NarodniySputnik/Gladiolus-1/README.md

# Проект Gladiolus-1 (Народный Спутник)
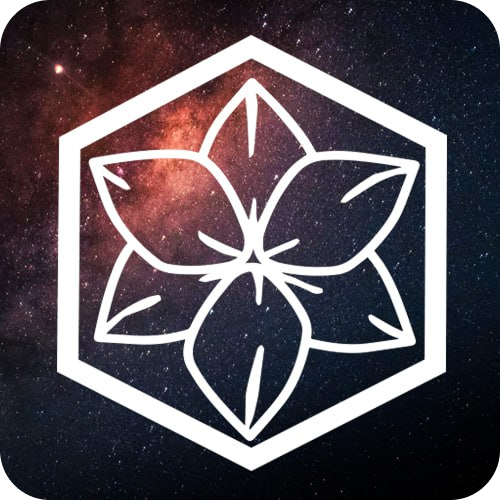
[picture p1: doc/img/logo.png]


Мы - команда радиолюбителей-энтузиастов под руководством Дмитрия R4UAB Пашкова!
В данный момент мы работаем над проектом "Народный спутник"! 
Наша цель - это создание функционального малого космического аппарата (CubeSat) для популяризации радиолюбительства, как интересного и увлекательного занятия для людей всех возрастов. Проект создаётся полностью на добровольных началах и заинтересованности наших участников. 

Наши задачи: 

- Реализовать полный цикл создания малого космического аппарата CubeSat - от проектирования и сборки до запуска и работы на орбите. 
- Предоставить открытые данные и существующие наработки по проекту для всех желающих, вдохновить всех любителей космической тематики и радиолюбителей на разработку и участие в новых интересных технологических проектах. 
- Объединить единомышленников для практической работы в области космических технологий и радиосвязи.

С огромнейшим удовольствием примем в нашу команду всех кто может и хочет приложить руку к созданию реального космического аппарата!

We are a team of amateur radio enthusiasts led by Dmitry "R4UAB" Pashkov!
We are currently working on the "People's Satellite" project! Our goal is to create a functional small spacecraft (CubeSat) to popularize amateur radio as an interesting and engaging activity for people of all ages. The project is being developed entirely on a voluntary basis and based on the passion of our participants.

Our goals:

- Implement the full development cycle of the CubeSat small spacecraft-from design and assembly to launch and operation in orbit.
- Provide open data and existing project developments to everyone, inspiring all space enthusiasts and radio amateurs to develop and participate in new exciting technological projects.
- Bring together like-minded individuals for practical work in the field of space technology and radio communications.

We are delighted to welcome anyone who can and wants to contribute to the creation of a real spacecraft to our team!

## Структура директорий
- doc - Документы
	- ds - Технические спецификации
	- img - Изображения
	- info - Информация
	- ref - Референсы и примеры
- firmware - Прошивки
- hardware - Печатные платы и схемы
	- library - Библиотеки KiCad
- software - Программы

## Назначение модуля
Gladiolus-1 - автономный модуль для приема и передачи изображений в формате SSTV (Slow Scan TeleVision) на малом космическом аппарате (МКА) формата CubeSat

1.2. Основание для разработки
Решение технического комитета проекта «Gladiolus-1» 

1.3. Назначение
Создание функциональной полезной нагрузки для:

Приёма команд с Земли <br>
Съёмки поверхности Земли <br>
Генерации и передачи изображений в формате SSTV <br>
Приёма и ретрансляции цифровых пакетных данных <br>
Проведения образовательных и научных экспериментов

1.4. Краткое описание системы<br>
Полезная нагрузка представляет собой модульную систему, построенную на основе единой шинной архитектуры. Система включает в себя два вычислительных блока различной архитектуры, обеспечивающих резервирование и распределение функций, два идентичных модемных блока с возможностью взаимозамены, центральный блок управления питанием и данными, а также антенную систему.

2. ОБЩИЕ ТРЕБОВАНИЯ

2.1. Эксплуатационные характеристики

<div align="left">
<table>
<tr><td>Формат:</td><td>CubeSat 1U (габариты 100×100×113,5 мм)</td></tr>
<tr><td>Орбита:</td><td>Низкая околоземная орбита (высота 500–600 км), солнечно-синхронная</td></tr>
<tr><td>Энергопотребление среднее:</td><td>не более 2Вт</td></tr>
<tr><td>Энергопотребление пиковое:</td><td>Не более 5Вт</td></tr>
<tr><td>Масса:</td><td>Не более 1.33кг</td></tr>
<tr><td>Габариты:</td><td>Соответствуют стандарту CubeSat 1U</td></tr>
</table></div>
Режимы работы должны обеспечивать положительный энергобаланс

2.2. Условия эксплуатации

<div align="left">
<table>
<tr><td>Температурный диапазон:</td><td>–40°C до +80°</td></tr>
<tr><td>Вибронагрузки:</td><td>Соответствуют стандартам запуска CubeSat</td></tr>
<tr><td>Ударные нагрузки:</td><td>До 100g</td></tr>
<tr><td>Вакуум:</td><td>До 10⁻⁶ Торр</td></tr>
<tr><td>Радиационная стойкость:</td><td>Критическая накопленная доза облучения 20 крад (Si)</td></tr>
</table></div>

2.3. Интерфейсы с платформой спутника
<div align="left"><table>
<tr><td>Питание:</td><td>Напряжение шины питания 3.2-8.4 В, ток до 1 А</td></tr>
<tr><td>Механический интерфейс:</td><td>Стандартные крепления CubeSat</td></tr>
<tr><td>Тепловой интерфейс:</td><td>Кондуктивный отвод тепла на платформу</td></tr>
<tr><td>Другие интерфейсы:</td><td>Не предусмотрены</td></tr>

</table></div>

3. ФУНКЦИОНАЛЬНОЕ ДЕЛЕНИЕ И ТРЕБОВАНИЯ К БЛОКАМ

3.1. БЦВМ 1 (Бортовая Цифровая Вычислительная Машина 1)

3.1.1. Аппаратная платформа:

<div align="left"><table>
<tr><td>Основной процессор:</td><td>Raspberry Pi Zero v1.3</td></tr>
<tr><td>Память:</td><td>Оперативная 512 МБ, флеш-память microSD</td></tr>
<tr><td>Тактовая частота:</td><td>Программно регулируемая от минимальной до номинальной</td></tr>
<tr><td>Отключаемые интерфейсы:</td><td>USB, HDMI, ненужные периферийные модули</td></tr>
</table></div>

3.1.2. Функции:

<div align="left">
<table>
<tr><td>Управление файловой системой бортового накопителя</td></tr>
<tr><td>Общее управление системой и координация работы блоков</td></tr>
<tr><td>Обработка команд и телеметрии</td></tr>
<tr><td>Маршрутизация данных между подсистемами</td></tr>
<tr><td>Резервная функция программной генерации сигнала SSTV</td></tr>
<tr><td>Ведение журнала работы системы</td></tr>
</table></div>

3.1.3. Интерфейсы:

<div align="left">
<table>
<tr><td>1× 40-контактный разъем для подключения к материнской плате</td></tr>
<tr><td>Поддержка шин RS-485 и I2C</td></tr>
</table></div>

3.2. БЦВМ 2 (Бортовая Цифровая Вычислительная Машина 2)

3.2.1. Аппаратная платформа: <br>
Основной микроконтроллер: STM32 серии (конкретная модель по результатам анализа) <br>
Периферия: <br>
Встроенный RTC с независимым питанием <br>
Интерфейс DCMI для подключения камеры <br>
2× UART для шин RS-485 <br>
Интерфейсы I2C, SPI для дополнительной периферии <br>
Внешняя SPI-Flash или SD-карта для хранения данных <br>
Режимы работы: Поддержка энергоэффективных режимов <br>

3.2.2. Функции:
Управление камерой: инициализация, захват кадра, настройка параметров <br>
Обработка изображений и подготовка данных для передачи в формате SSTV <br>
Управление SSTV-передатчиком <br>
Синхронизация операций по времени с помощью RTC <br>
Дублирующее управление бортовым накопителем <br>
Резервирование критических функций БЦВМ 1 <br>

3.2.3. Взаимодействие между БЦВМ:
Обмен данными через единые шины RS-485 <br>
Взаимный мониторинг состояния и работоспособности <br>
Автоматическое перераспределение функций при отказах <br>
Синхронизация времени и планирование задач

3.3. Модемный блок (в количестве 2 шт.)
3.3.1. Аппаратная основа:

<div align="left"><table>
<tr><td>Радиомодули:</td><td>На каждый блок: Ra-02 (на основе SX1278)</td></tr>
<tr><td>Усилители:</td><td>МШУ на приём, усилитель AB-IOT-433 передачу</td></tr>
<tr><td>Фильтры:</td><td>ПАВ-фильтры на приём и передачу</td></tr>
<tr><td>Согласующие цепи:</td><td>Wideband matching networks</td></tr>
<tr><td>Микроконтроллер:</td><td>MSP430FR5994IPNR</td></tr>
</table></div>

3.3.2. Функциональное назначение:

<div align="left">
<table>
<tr><td>Радиомодуль 1:</td><td>SSTV передатчик (ЧМ модуляция, 438МГц)</td></tr>
<tr><td>Радиомодуль 2:</td><td>Цифровая радиолиния (435Мгц)</td></tr>
<tr><td>Резервирование:</td><td>Возможность переконфигурации модулей</td></tr>
</table></div>

3.3.3. Электрические параметры:

<div align="left">
<table>
<tr><td>Мощность передатчика:</td><td>До 2Вт (регулируемая)</td></tr>
<tr><td>Чувствительность приёмника:</td><td>Не хуже -130dBm</td></tr>
<tr><td>Стабильность частоты:</td><td>±1 ppm</td></tr>
<tr><td>Потребляемый ток:</td><td>Передача ≤ 500 мА, прием ≤ 50 мА</td></tr>
</table></div>

3.3.4. Дополнительные функции:
Контроль температуры через I2C<br>
Мониторинг параметров усилителей<br>
Защита от КЗ и перегрева<br>
Автоматическая калибровка

3.4. Материнский блок (Блок управления питанием и данными)

3.4.1. Система питания:

<div align="left"><table>
<tr><td>Вход:</td><td>3.2-8.4В от платформы спутника</td></tr>
<tr><td>Выход:</td><td>Стабилизированное +5В через интеллектуальные ключи</td></tr>
<tr><td>КПД:</td><td>Не менее 90% при номинальной нагрузке</td></tr>
<tr><td>Защите:</td><td>Ограничение тока, защита от КЗ, от перенапряжения</td></tr>
</table></div>

3.4.2. Управление и мониторинг:

<div align="left">
<table>
<tr><td>Централизованный сбор телеметрии через I2C</td></tr>
<tr><td>Управление питанием каждого блока</td></tr>
<tr><td>Аппаратный watchdog (MAX6301)</td></tr>
<tr><td>Счетчик перезагрузок в энергонезависимой памяти</td></tr>
</table></div>

3.4.3. Интерфейсы:

<div align="left">
<table>
<tr><td>4× 40-контактных разъема для функциональных блоков</td></tr>
<tr><td>2× шины RS-485 с протоколом AX.25</td></tr>
<tr><td>Шина I2C с мультиплексором для изоляции подключенных блоков</td></tr>
</table></div>

3.4.4. Система I2C мультиплексирования:
Архитектура: Мультиплексор I2C с 8 и более каналами

Назначение каналов:

<div align="left">
<table>
<tr><td>Канал 0:</td><td>Внутренние датчики материнского блока</td></tr>
<tr><td>Канал 1:</td><td>БЦВМ</td></tr>
<tr><td>Канал 2:</td><td>БЦВМ</td></tr>
<tr><td>Канал 3:</td><td>Модемный блок 1</td></tr>
<tr><td>Канал 4:</td><td>Модемный блок 2</td></tr>
<tr><td>Канал 5:</td><td>Резерв</td></tr>
<tr><td>Канал 6:</td><td>Резерв</td></tr>
<tr><td>Канал 7:</td><td>Резерв</td></tr>
</table></div>

<div align="left">
<table>
<tr><td>Управление:</td><td>Программное переключение каналов мультиплексора</td></tr>
<tr><td>Восстановление:</td><td>Автоматический сброс зависших устройств</td></tr>
</table></div>

3.4.5. Мониторинг питания: <br>
Детектирование аварий: Мониторинг напряжения на линии PWR_FAULT <br>
Реакция на аварии: Автоматическое отключение питания блока при аварии <br>
Логирование: Запись событий аварий питания

3.5. Антенный блок
<div align="left"><table>
<tr><td>Диапазоны:</td><td>435 и 438МГц</td></tr>
<tr><td>Поляризация:</td><td>Линейная</td></tr>
<tr><td>КСВ:</td><td>Не более 1.5 в рабочем диапазоне</td></tr>
<tr><td>Конструктив:</td><td>Складываемая конструкция, совместимая с 1U CubeSat</td></tr>
<tr><td>Коэффициент усиления:</td><td>Не менее 0 dBi для каждого диапазона</td></tr>
<td>Диаграмма направленности:</td><td>Широконаправленная для обеспечения связи при различных ориентациях спутника</td></tr>
</table></div>

3.6. Требования к унификации блоков

3.6.1. Стандартизация разъемов:<br>
Единый 40-контактный разъем для всех блоков <br>
Фиксированная распиновка (см. Таблицу 1) <br>
Механическая фиксация от самопроизвольного отключения

Таблица 1. Распиновка 40-контактного разъема
<div align="left">
<table>
<tr>
<th>Контакты</th><th>Назначение</th><th>Описание</th></tr>
<tr><td>1-4</td><td>+5V</td><td>Питание +5В</td></tr>
<tr><th>5-8</th><th>GND</th><th>Земля</th></tr>
<tr><td>I2C</td><td>SCL</td><td>SCL</td></tr>
<tr><td>I2C</td><td>SDA</td><td>SDA</td></tr>
<tr><td>I2C_PWR</td><td></td><td>Плюс питания</td></tr>
<tr><td>I2C_GND</td><td></td><td>Земля</td></tr>
<tr><td>A1, B2</td><td>RS-485</td><td>2 контакта</td></tr>
<tr><td>PWR_EN</td><td>управление</td><td>включение питания</td></tr>
<tr><td>RESET</td><td>Сброс</td><td>включение питания</td></tr>
<tr><td>PWR_FAULT</td><td>Мониторинг</td><td>1 контакт</td></tr>
<tr><td>PWR_FAULT</td><td>Резерв</td><td>21 контакт</td></tr>
</table></div>

3.6.2. Организация шин:<br>
Параллельное подключение всех блоков к общим шинам<br>
Индивидуальное управление питанием<br>
Единые протоколы обмена

4. ТРЕБОВАНИЯ К ИНТЕРФЕЙСАМ И ПРОТОКОЛАМ

4.1. Физический уровень
RS-485: Двухпроводная дифференциальная шина<br>
Скорость: 1200-2000000 бод<br>
I2C: Стандартный протокол с тактовой частотой до 400 кГц (Fast Mode)

<div align="left"><table>
<tr><td>RS-485</td><td>Двухпроводная дифференциальная шина</td></tr>
<tr><td>Скорость:</td><td>1200-2000000 бод</td></tr>
<tr><td>I2C</td><td>Стандартный протокол с тактовой частотой до 400 кГц</td></tr>
</table></div>

4.2. Протокол обмена

<div align="left"><table>
<tr><td>Базовый протокол</td><td>AX.25</td></tr>
<tr><td>Формат пакетов</td><td>HDLC-like frame structure</td></tr>
<tr><td>Контроль ошибок</td><td>CRC-16</td></tr>
<tr><td>Адресация</td><td>расширенная схема адресации подсистем</td></tr>
</table></div>

4.3. Логика работы <br>
Широковещательная и адресная передача <br>
Подтверждение приема критических команд <br>
Повторная передача при ошибках <br>
Приоритезация пакетов

4.4. Протокол обмена по I2C

<div align="left"><table><tr>
<td>Адресация устройств</td><td>7-битная схема адресации</td></tr>
<tr><td>Скорость обмена</td><td>до 400 кбит/сек</td></tr>
<tr><td>Формат сообщений</td><td>Управляющие команды <br> Данные телеметрии <br> Статусные сообщения</td></tr>
<tr><td>Арбитраж</td><td>Автоматическое разрешение коллизий</td></tr>
<tr><td>Таймауты</td><td>Защита от зависания шины</td></tr>
</table></div>

5. МЕХАНИЧЕСКИЕ И КОНСТРУКТИВНЫЕ ТРЕБОВАНИЯ

5.1. Компоновка

<div align="left"><table>
<tr><td>Формат</td><td>1U CubeSat (100x100x113, 5мм)</td></tr>
<tr><td>Количество плат:</td><td>3-4 печатных платы в стэке</td></tr>
<tr><td>Высота компонентов:</td><td>С учётом зазора между платами</td></tr>
</table></div>

5.2. Материалы

<div align="left"><table>
<tr><td>Основа плат:</td><td>FR-4 c Tg ≥ 170°C</td></tr>
<tr><td>Покрытие:</td><td>Конформное покрытие для защиты от влаги и загрязнений</td></tr>
<tr><td>Защитные покрытия:</td><td>Использование металлов без защитного покрытия не допускается. Все металлические поверхности должны иметь защитное покрытие для функционирования в космических условиях</td></tr>
<tr><td>Монтажные компоненты:</td><td>Использование оловянно-свинцовых припоев (Sn63Pb37 или аналог). Бессвинцовые припои не допускаются.</td></tr>
</table></div>

5.3. Тепловой режим <br>
Пассивное охлаждение через корпус<br>
Распределение тепловыделяющих компонентов<br>
Тепловой контакт с платформой спутника

6. ТРЕБОВАНИЯ К НАДЁЖНОСТИ

6.1. Показатели надежности

<div align="left">
<table>
<tr><td>Средняя наработка на отказ:</td>
<td>≥ 10 000 часов</td></tr>
<tr><td>Вероятность безотказной работы:</td>
<td>≥ ≥ 0.95 за 1 год</td></tr>
<tr><td>Коэффициент готовности:</td>
<td>≥ 0.98</td></tr>
</table></div>

6.2. Радиационная стойкость

6.2.1. Критерии стойкости: <br>
Сохранение работоспособности до 20 крад (Si)<br>
Постепенная деградация параметров после 20 крад<br>
Сохранение базовой функциональности до 25 крад

6.2.2. Методы обеспечения: <br>
Выбор компонентов с подтвержденной стойкостью<br>
Локальные экраны для чувствительных элементов<br>
Схемная избыточность и резервирование<br>
RAD-HARD компоненты для критических узлов

6.2.3. Испытания: <br>
Радиационные испытания на ускорителях<br>
Контроль параметров при дозах 10, 15, 20, 25 крад<br>
Тестирование на SEE и SEL<br>
Термоциклирование после облучения

6.2.4. Расчетные параметры: <br>
Запас 20% относительно расчетной дозы<br>
Учет всех видов ионизирующего излучения<br>
Моделирование радиационной обстановки

7. ТРЕБОВАНИЯ К ОТЛАДОЧНОМУ ОБОРУДОВАНИЮ

7.1. Плата-удлинитель для внешней отладки

7.1.1. Конструкция: <br>
Печатная плата с посадочным местом для функционального блока<br>
Штатный 40-контактный разъем со стороны спутника<br>
Механическое крепление блока винтами<br>
Тестовые точки и защитные элементы

7.1.2. Параметры: <br>
Сопротивление проводников: ≤ 0.1 Ом
Рабочая температура: -40°C до +80°C
Стойкость к вибрациям согласно требованиям

<div align="left"><table>
<tr><td>Сопротивление проводников:</td><td> ≤ 0.1 Ом</td></tr>
<tr><td>Рабочая температура:</td><td>-40°C до +80°C</td></tr>
<tr><td>Стойкость к вибрациям:</td><td>Cогласно требованиям</td></tr>
</table></div>

7.2. Плата-эмулятор материнской платы <br>
7.2.1. Функционал:
Эмуляция штатной материнской платы<br>
Управление питанием подключенного блока<br>
Мониторинг токопотребления<br>
Организация шин RS-485 и I2C

7.2.2. Интерфейсы: <br>
1× 40-контактный разъем для блока<br>
USB Type-C для питания и связи<br>
JTAG для низкоуровневой отладки<br>

7.2.3. Программное обеспечение: <br>
Графическая утилита для управления<br>
Эмуляция штатных режимов работы<br>
Логирование и анализ данных<br>
Библиотека тестовых сценариев<br>
Мониторинг шины I2C в реальном времени

7.2.4. Технические характеристики:

<div align="left"><table>
<tr><td>Входное напряжение</td><td>12 В DC или USB-C</td></tr>
<tr><td>Выходной ток</td><td>До 2А</td></tr>
<tr><td>Поддержка скоростей RS-485:</td><td>1200 бод - 2 Мбод</td></tr>
<tr><td>Поддержка I2C:</td><td>Standard Mode (100 кГц), Fast Mode (400 кГц)</td></tr>
<tr><td>Рабочая температура:</td><td>0°C до +50°C</td></tr>
</table></div>

7.3. Совместимость <br>
Полная электрическая и программная совместимость<br>
Использование в термовакуумной камере<br>
Соответствие требованиям наземных испытаний

8. ЭТАПЫ РАЗРАБОТКИ И ИСПЫТАНИЙ

8.1. Основные этапы <br>
Эскизное проектирование<br>
Разработка конструкторской документации<br>
Изготовление опытных образцов<br>
Проведение испытаний<br>
Изготовление летного образца<br>
Сопровождение запуска и эксплуатации

8.2. Виды испытаний <br>
Вибродинамические<br>
Термовакуумные<br>
Радиационные<br>
Электромагнитная совместимость<br>
Функциональные и комплексные

8.3. Требования к вибродинамическим испытаниям
8.3.1. Условия проведения испытаний: <br>
Температура: +20°C ±5°C <br>
Относительная влажность: 40-60% <br>
Крепление образца: Штатные крепежные элементы, момент затяжки согласно конструкторской документации <br>

8.3.2. Режимы вибрационных испытаний:

<div align="left">
<table>
<tr><th>Синусоидальная вибрация</th></tr>
<tr><td>Диапазон частот:</td><td>5-100Гц</td></tr>
<tr><td>Амплитуда:</td><td>20g</td></tr>
<tr><td>Скорость развёртки:</td><td>2 октавы/мин</td></tr>
<tr><td>Направления:</td><td>X, Y, Z оси</td></tr>
<tr><td>Количество циклов:</td><td>3 цикла на каждое направление</td></tr>
<tr><th>Случайная вибрация</th></tr>
<tr><td>Диапазон частот:</td><td>20-2000Гц</td></tr>
<tr><td>Спектральная плотность 20-100Гц</td><td>+3 дБ/окт</td></tr>
<tr><td>Спектральная плотность 100-700Гц</td><td>0.04 g²/Гц</td></tr>
<tr><td>Спектральная плотность 700-2000Гц</td><td>-3 дБ/окт</td></tr>
<tr><td>Общее СКУ ускорение</td><td>7.7 g (среднеквадратичное)</td></tr>
<tr><td>Длительность:</td><td>2 минуты на каждое направление</td></tr>
<tr><td>Направления:</td><td>X, Y, Z оси</td></tr>
</table></div>

8.3.3. Контроль во время испытаний: <br>
Непрерывный мониторинг электрических параметров<br>
Регистрация резонансных частот<br>
Визуальный контроль после каждого этапа испытаний<

8.3.4. Критерии успешного прохождения: <br>
Отсутствие механических повреждений<br>
Сохранение функциональности системы<br>
Отсутствие необратимых изменений параметров<br>
Соответствие резонансных частот требованиям конструкции

8.4. Требования к термовакуумным испытаниям

8.4.1. Условия проведения испытаний:

<div align="left">
<table>
<tr><td>Вакуум:</td><td>≤ 10⁻⁵ Торр</td></tr>
<tr><td>Температурный диапазон:</td><td>-40°C до +80°C</td></tr>
<tr><td>Скорость изменения температуры:</td><td>не более 5°C/мин</td></tr>
<tr><td>Температурные датчики:</td><td>не менее 6 точек контроля</td></tr>
</table></div>

8.4.2. Профиль температурных циклов:

<div align="left">
<table>
<tr><th>Квалификационные испытания</th></tr>
<tr><td>Количество циклов:</td><td>8 циклов</td></tr>
<tr><td>Выдержка на экстремумах:</td><td>4 часа</td></tr>
<tr><td>Температурный диапазон:</td><td>-45°C до +85°C</td></tr>
<tr><th>Приёмо-сдаточные испытания</th></tr>
<tr><td>Количество циклов:</td><td>4 цикла</td></tr>
<tr><td>Выдержка на экстремумах:</td><td>2 часа</td></tr>
<tr><td>Температурный диапазон:</td><td>-40°C до +80°C</td></tr>
</table></div>

8.4.3. Контроль параметров: <br>
Электрические параметры: <br>
Потребляемый ток в различных режимах<br>
Стабильность напряжений питания<br>
Работоспособность интерфейсов связи<br>
Функциональные проверки:<br>
Проверка работы камеры на всех температурах<br>
Тестирование радиоканалов<br>
Проверка систем обработки данных

8.4.4. Тепловой баланс:

<div align="left"><table>
<tr><td>Мощность нагревателей:</td><td>регулируемая, с точностью ±1°C</td></tr>
<tr><td>Охлаждение:</td><td>жидкий азот или механическое охлаждение</td></tr>
<tr><td>Стабилизация температуры:</td><td>±2°C от заданной</td></tr>
</table></div>

8.4.5. Критерии успешного прохождения: <br>
Отсутствие деградации материалов и покрытий в вакууме (улетучивания, растрескивания)<br>
Сохранение герметичности компонентов<br>
Стабильность электрических параметров в течение всего цикла<br>
Отсутствие сбоев в работе программного обеспечения<br>
Сохранение механической целостности после термических расширений/сжатий<br>
Соответствие тепловых режимов расчетным значениям

## Состав команды | Team members

### Руководитель проекта | Team leader
- @r4uab

### Главный Конструктор | Chief Designer
- AnatoliySV

### Разработка антенны | Antenna development
- @stellar_alice
- @SV2HWM
- @Esprit_bel

### Разработка радиотракта | Radio path development
- @ub1qbm
- @PhaseShifting
- @ub8qbd

### Экспертная команда | Expert team
- @R2FAL
- @baskiton
- @RA3PPY

### Технические писатели | Technical writers
- @Esprit_bel

### Программисты | Programmers
- @cugadese
