NarodniySputnik/Gladiolus-1/doc/ref/magnetometer/project/description.txt

/project
  |-- main.c               // основной код
  |-- pcf8563.c / .h       // драйвер PCF8563
  |-- qmc5883l.c / .h      // драйвер QMC5883L
  |-- i2c.c / .h           // I2C базовый
  |-- uart.c / .h          // UART с прерываниями TX/RX
  |-- fatfs/               // FatFs библиотека (включая ff.c, ff.h и т.п.)
  |-- config.txt           // конфиг (создаётся на SD)
  |-- log.txt              // лог (создаётся на SD)
