NarodniySputnik/Gladiolus-1/doc/info/Описание_проекта_Народный_Спутник.pdf

Мы - команда радиолюбителей-энтузиастов под руководством

Дмитрия R4UAB Пашкова!

Мы хотим создать проект "Народный спутник"! Наша цель - это

создание функционального малого космического аппарата (CubeSat) для

популяризации радиолюбительства, как интересного и увлекательного занятия

для людей всех возрастов. Проект создаётся полностью на добровольных

началах и заинтересованности наших участников.

Наши задачи:

- Реализовать полный цикл создания малого космического аппарата

Cube Sat— от проектирования до запуска и работы на орбите.

- Предоставить открытые данные и наработки для всех желающих,

вдохновить всех любителей космической темы и радиолюбителей на новые

технологические проекты.

- Объединить единомышленников для практической работы в

области космических технологий и радиосвязи.

С огромнейшим удовольствием примем в нашу команду

всех кто может и хочет приложить руку к созданию реального

космического аппарата!
