NarodniySputnik/Gladiolus-1/hardware/3axis-magnitometer/magnitimetr.png

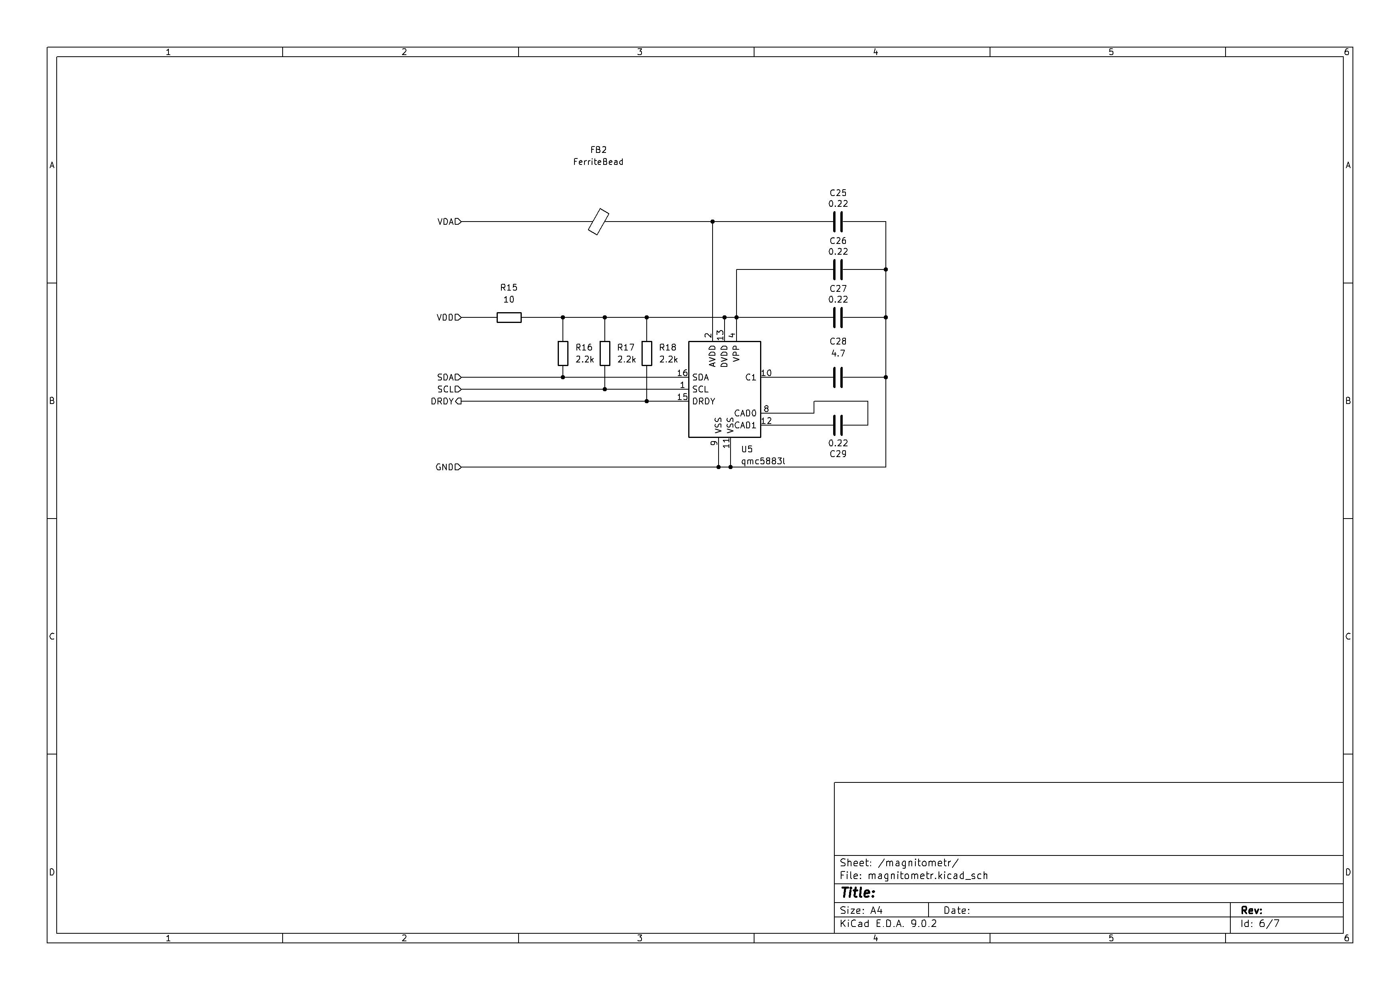
hardware/3axis-magnitometer/magnitimetr.png
