NarodniySputnik/Gladiolus-1/hardware/schema_infrastructure.JPG

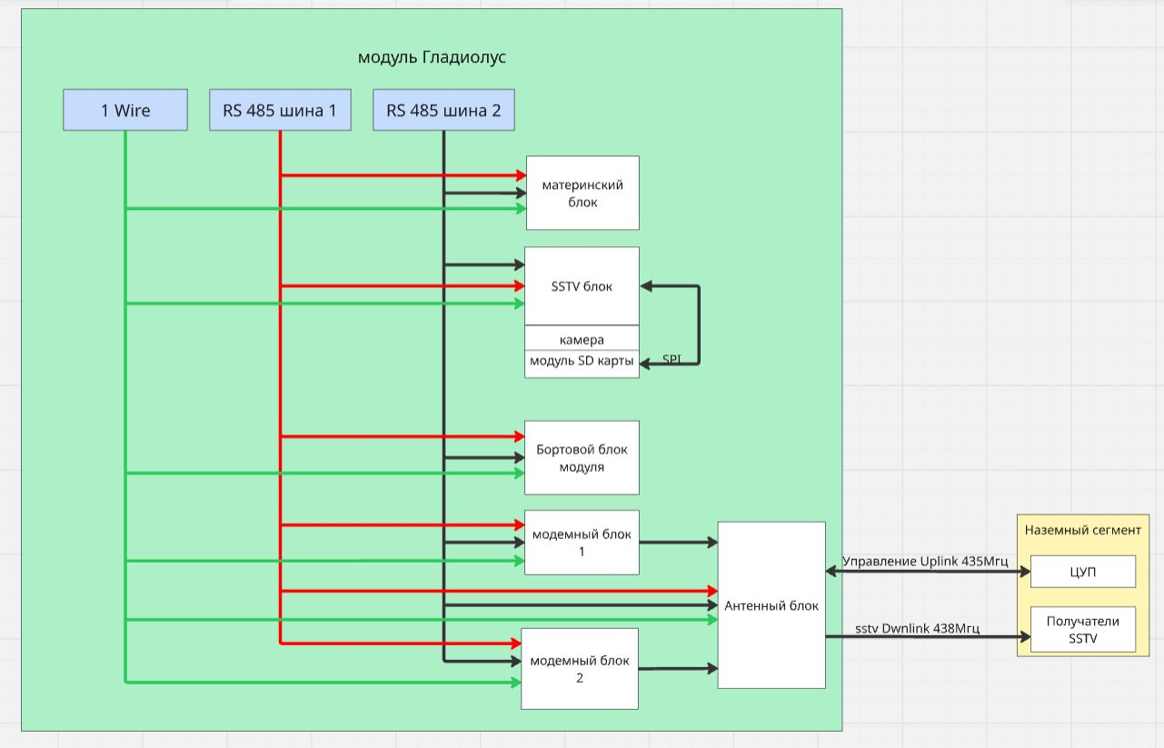
hardware/schema_infrastructure.JPG
