NarodniySputnik/Gladiolus-1/doc/ds/Antenna_Module/CX4002LNL.PDF

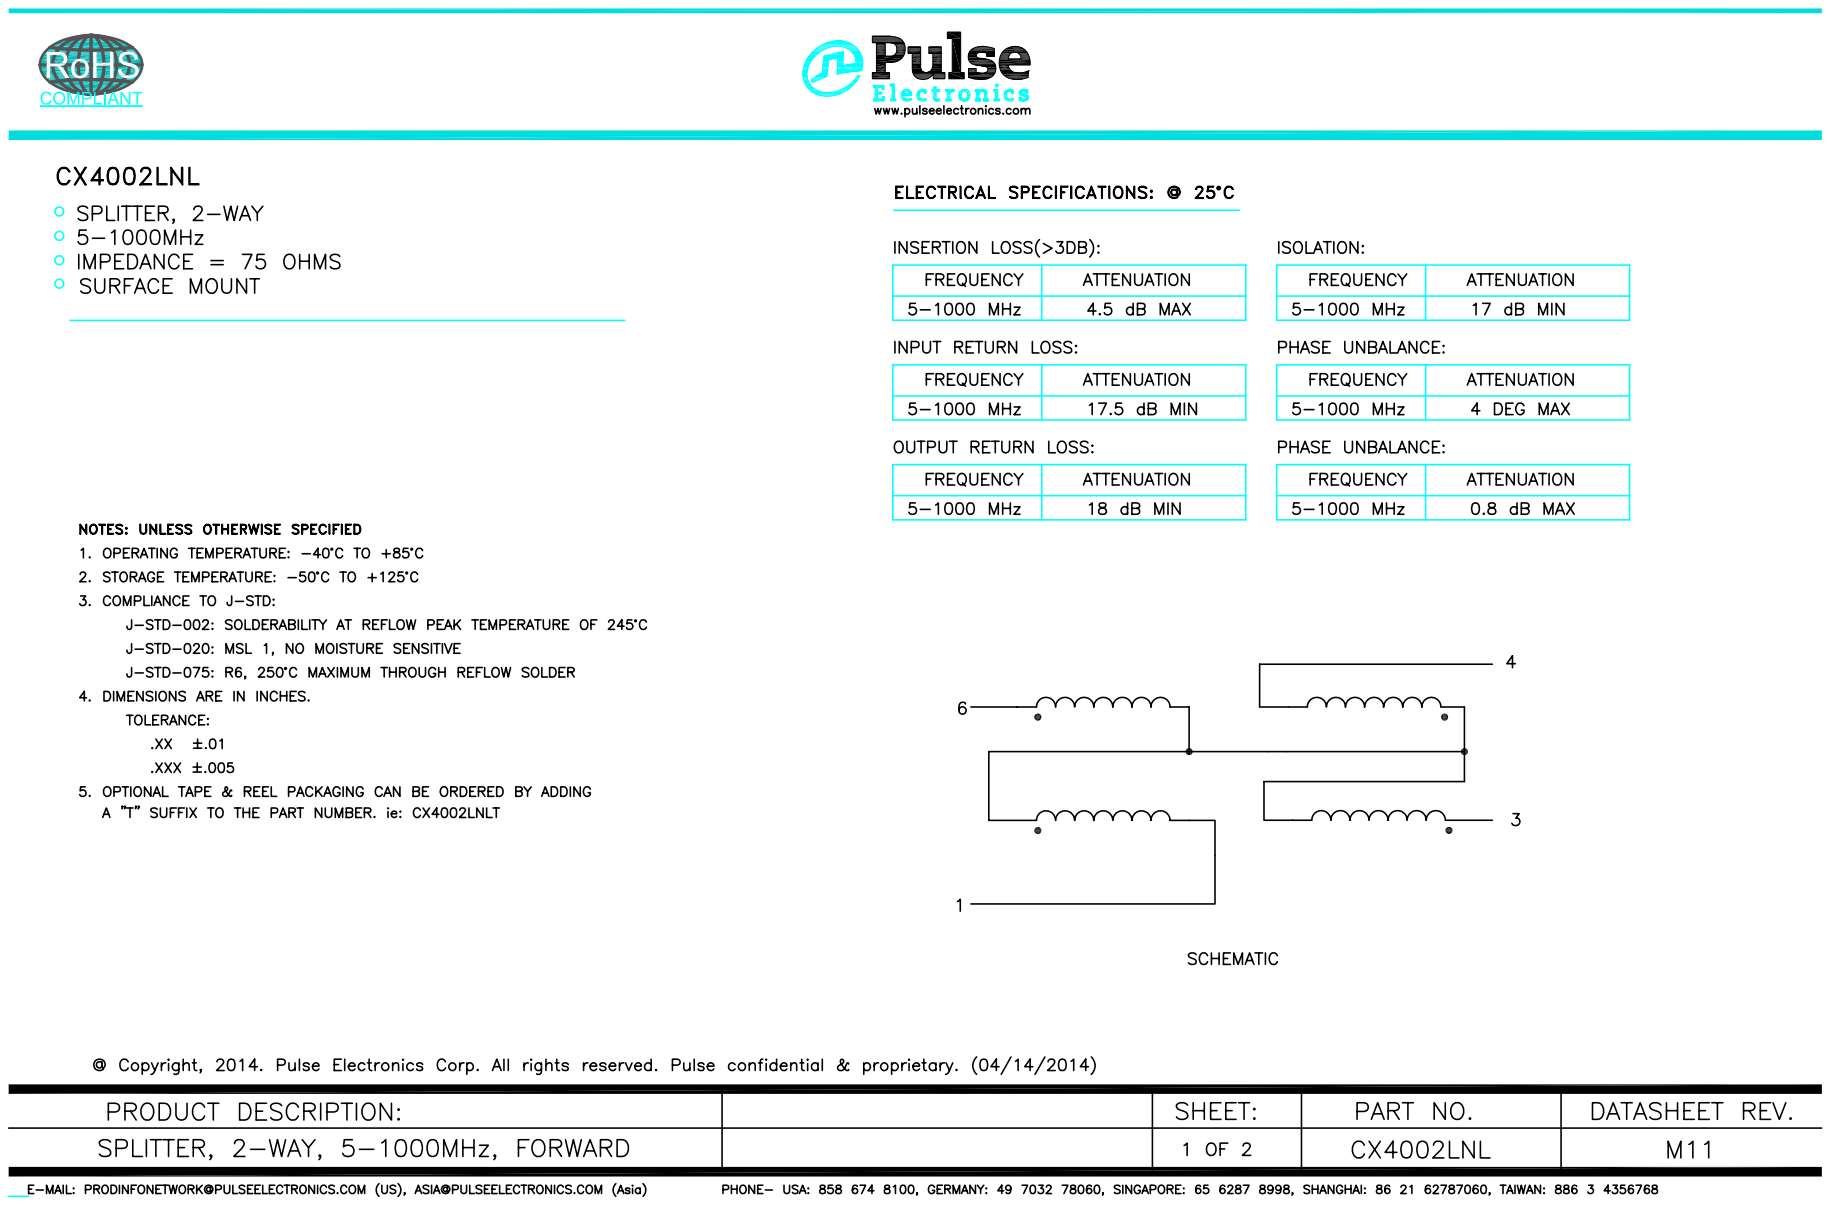
[picture p4: page 1]

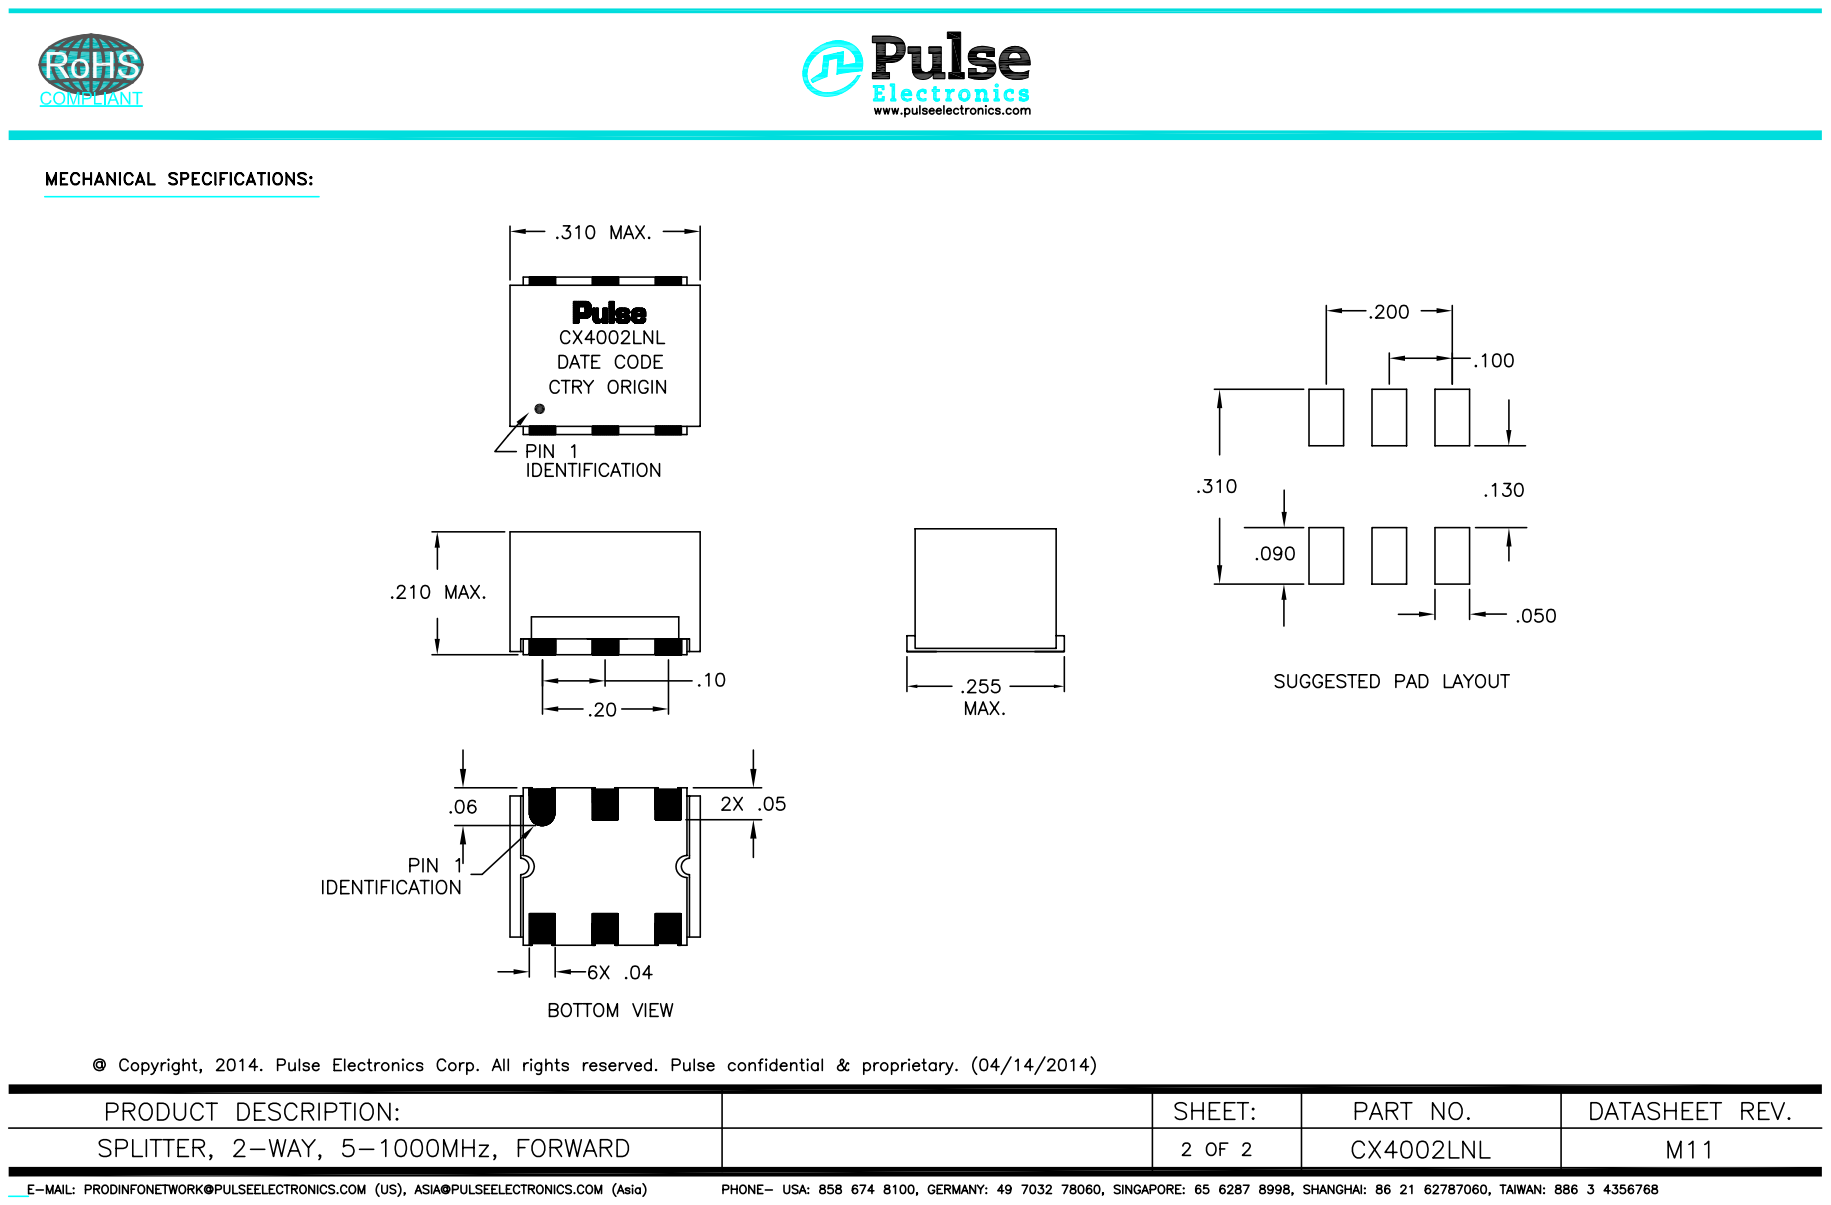
[picture p5: page 2]
