NarodniySputnik/Gladiolus-1/hardware/3axis-magnitometer/3axis-magnitometer.kicad_pcb

## KiCad design hardware/3axis-magnitometer/3axis-magnitometer.kicad_pcb (2026-04-07)

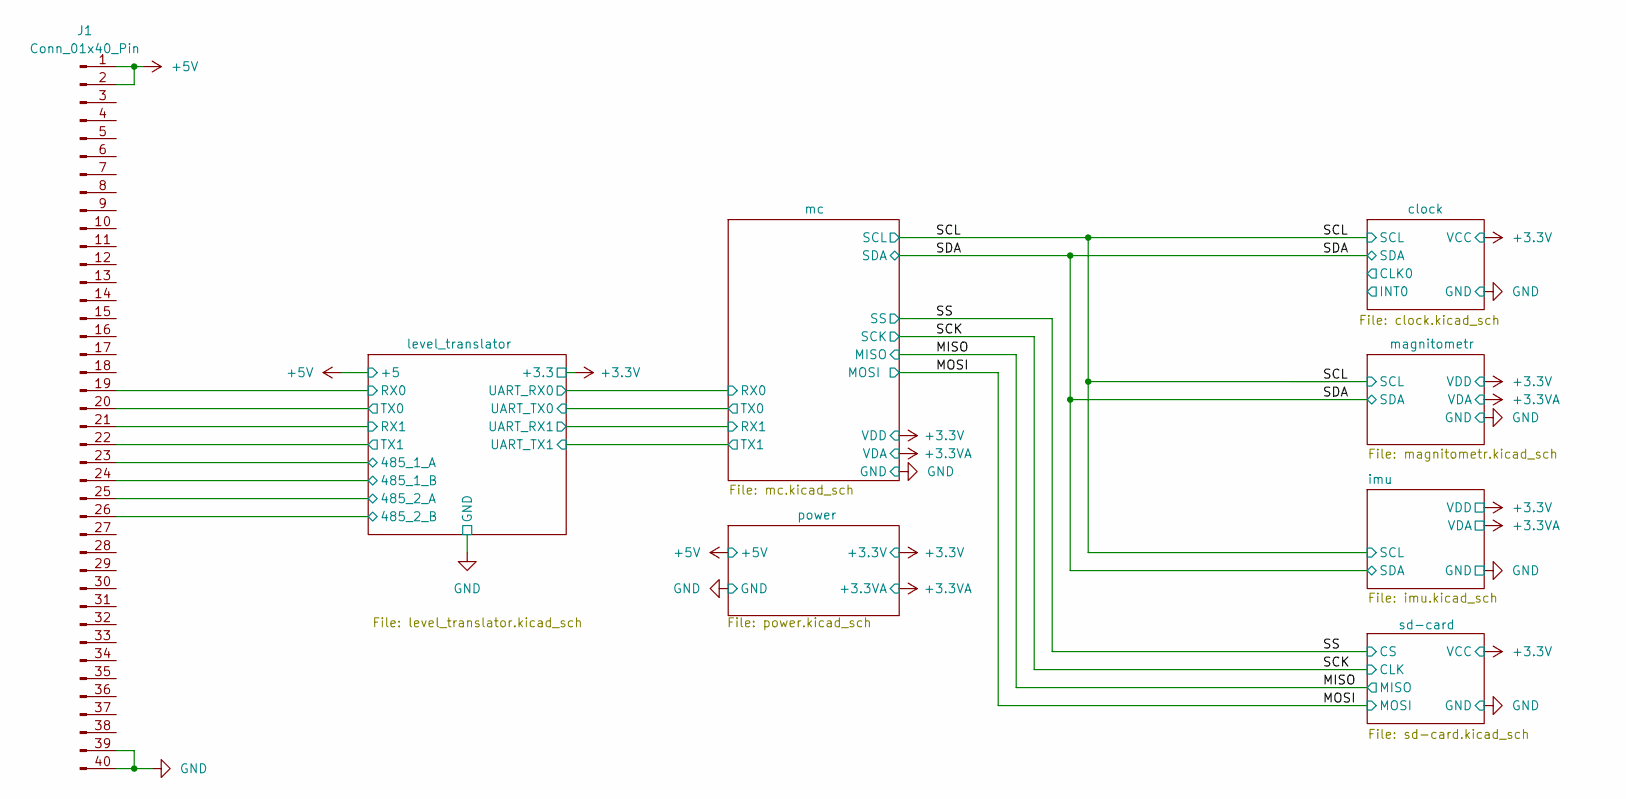
[picture p6: schematic 3axis-magnitometer.kicad_sch]

Parts:
J1: Conn_01x40_Pin; PinHeader_2x20_P2.54mm_Horizontal

Connections:
+5V: J1.1, J1.2; also elsewhere on the board
/level_translator/485_1_A: J1.23; also elsewhere on the board
/level_translator/485_1_B: J1.24; also elsewhere on the board
/level_translator/485_2_A: J1.25; also elsewhere on the board
/level_translator/485_2_B: J1.26; also elsewhere on the board
/level_translator/RX0: J1.19; also elsewhere on the board
/level_translator/RX1: J1.21; also elsewhere on the board
/level_translator/TX0: J1.20; also elsewhere on the board
/level_translator/TX1: J1.22; also elsewhere on the board
GND: J1.39, J1.40; also elsewhere on the board

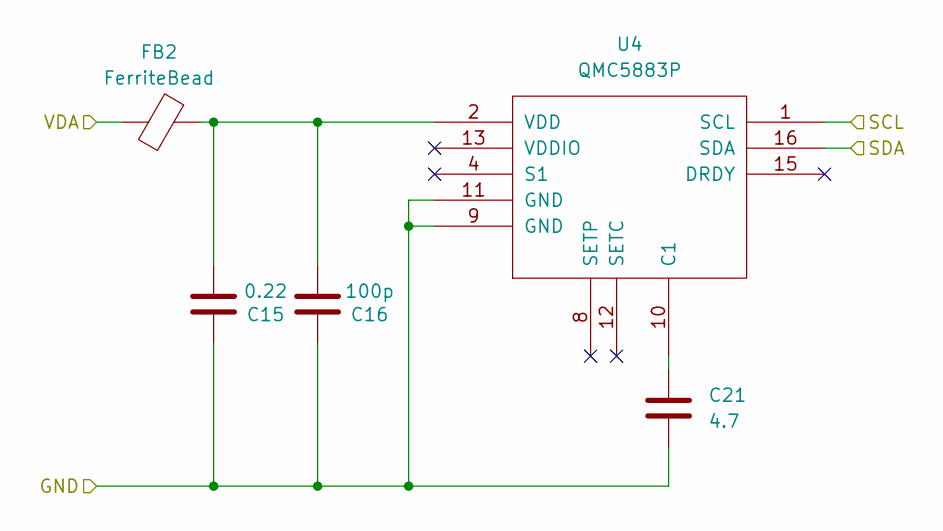
[picture p7: schematic magnitometr.kicad_sch]

Parts:
C15: 0.22; C_0805_2012Metric
C16: 100p; C_0805_2012Metric
C21: 4.7; C_0805_2012Metric
FB2: FerriteBead; L_0805_2012Metric
U4: QMC5883P; LGA-16_3x3mm_P0.5mm_LayoutBorder3x5y

Connections:
+3.3VA: FB2.1; also elsewhere on the board
/SCL: U4.1 (SCL); also elsewhere on the board
/SDA: U4.16 (SDA); also elsewhere on the board
GND: C15.2, C16.2, C21.2, U4.9 (GND), U4.11 (GND); also elsewhere on the board
unnamed: C21.1, U4.10 (C1)
unnamed: C15.1, C16.1, FB2.2, U4.2 (VDD)

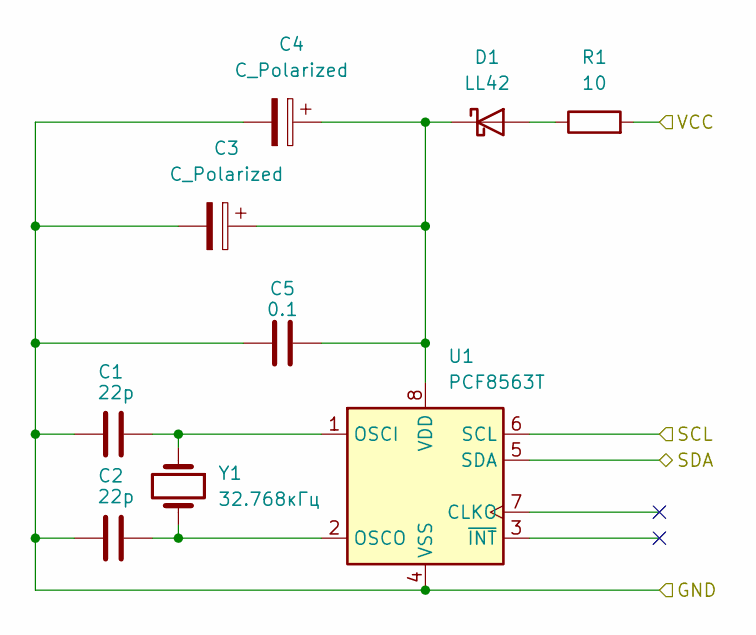
[picture p8: schematic clock.kicad_sch]

Parts:
C1, C2: 22p; C_0805_2012Metric
C3, C4: C_Polarized; DSK
C5: 0.1; C_0805_2012Metric
D1: LL42; D_MiniMELF
R1: 10; R_0805_2012Metric
U1: PCF8563T; SOIC-8_3.9x4.9mm_P1.27mm
Y1: 32.768кГц; Crystal_AT310_D3.0mm_L10.0mm_Horizontal_1EP_style2

Connections:
+3.3V: R1.2; also elsewhere on the board
/SCL: U1.6 (SCL); also elsewhere on the board
/SDA: U1.5 (SDA); also elsewhere on the board
GND: C1.2, C2.2, C3.2, C4.2, C5.1, U1.4 (VSS), Y1.3; also elsewhere on the board
unnamed: D1.2 (A), R1.1
unnamed: C3.1, C4.1, C5.2, D1.1 (K), U1.8 (VDD)
unnamed: C1.1, U1.1 (OSCI), Y1.1
unnamed: C2.1, U1.2 (OSCO), Y1.2

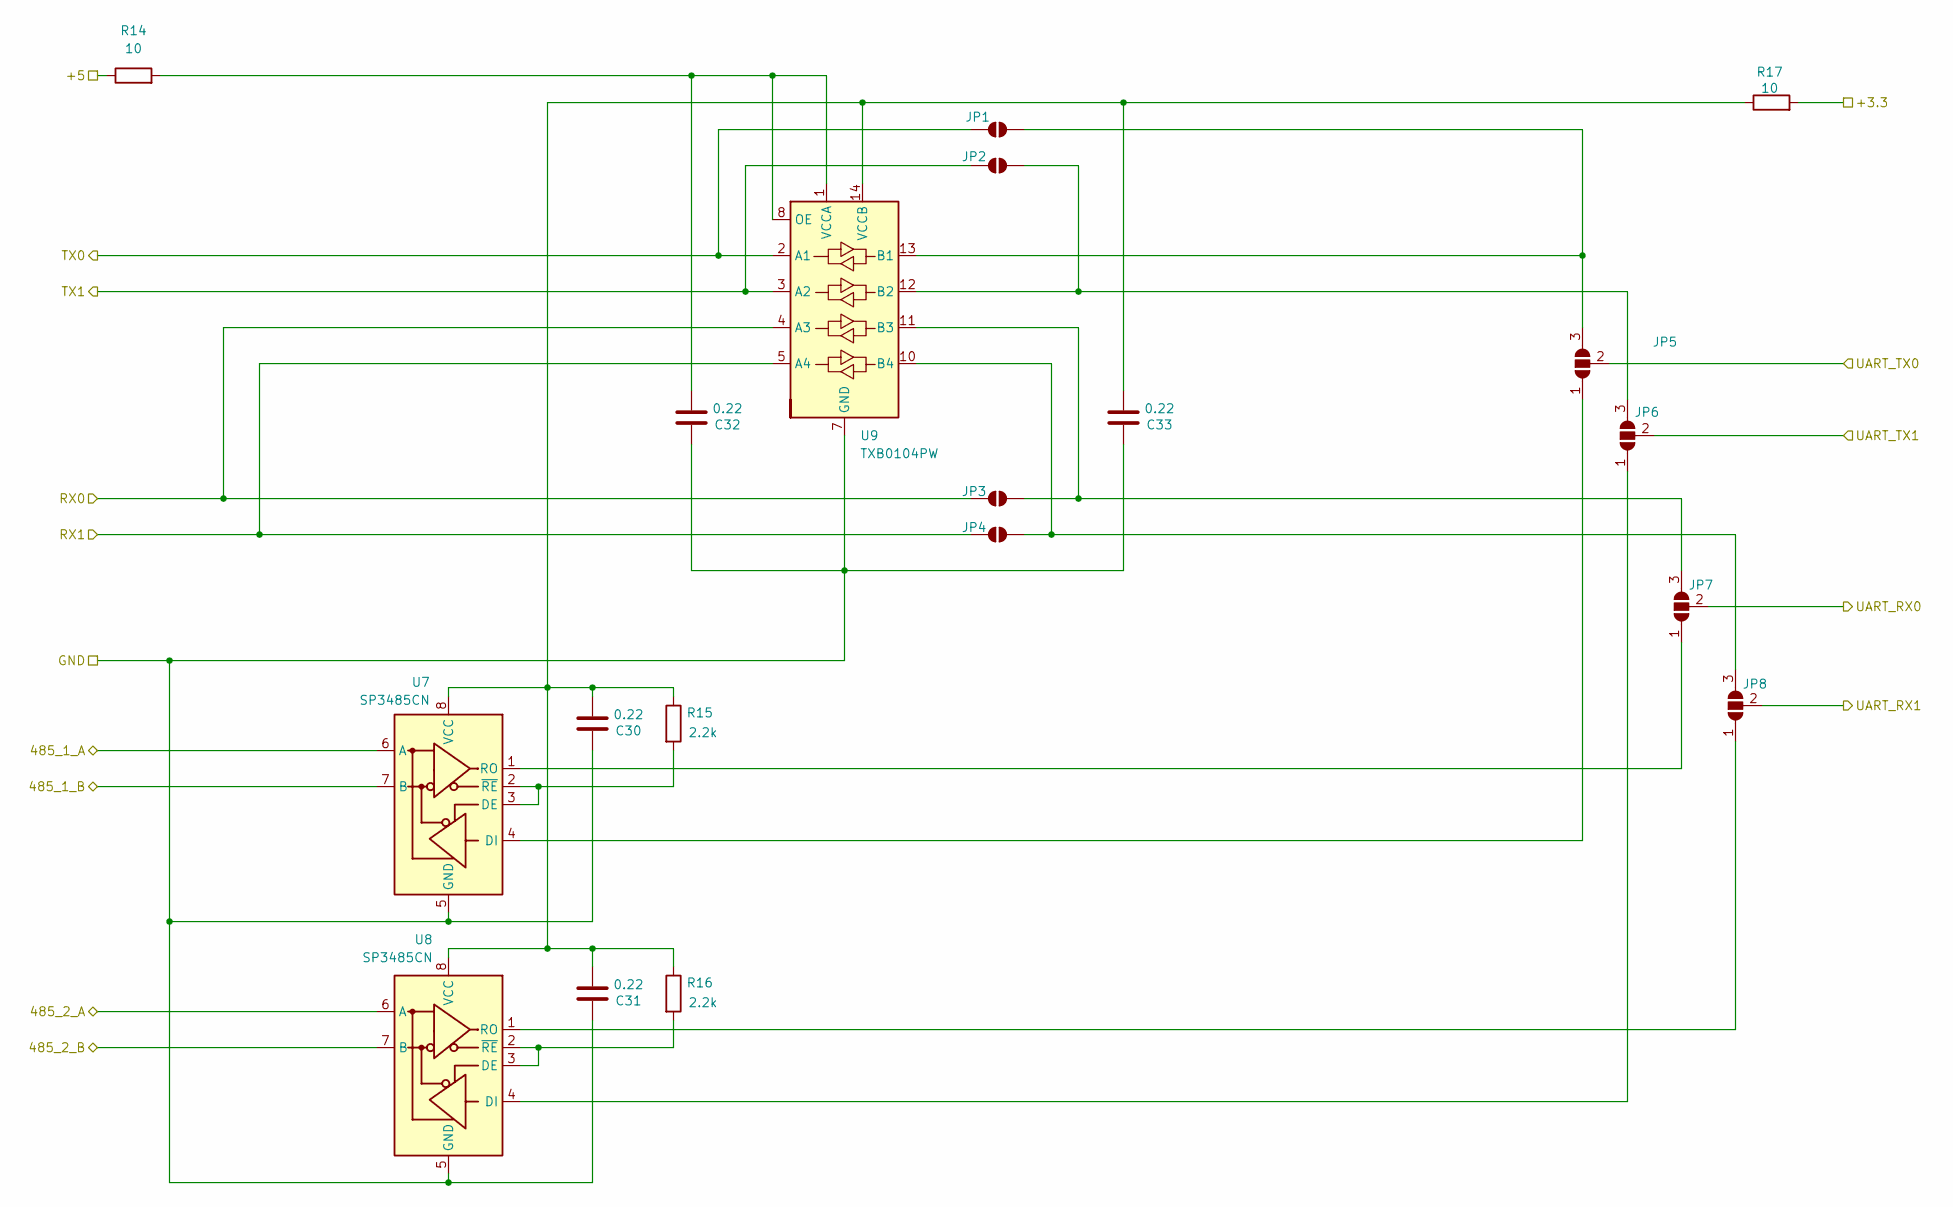
[picture p9: schematic level_translator.kicad_sch]

Parts:
C30, C31, C32, C33: 0.22; C_0805_2012Metric
JP1, JP2, JP3, JP4: SolderJumper_2_Open; SolderJumper-2_P1.3mm_Open_Pad1.0x1.5mm
JP5, JP6, JP7, JP8: SolderJumper_3_Open; SolderJumper-3_P1.3mm_Open_Pad1.0x1.5mm
R14, R17: 10; R_0805_2012Metric
R15, R16: 2.2k; R_0805_2012Metric
U7, U8: SP3485CN; SOIC-8_3.9x4.9mm_P1.27mm
U9: TXB0104PW; TSSOP-14_4.4x5mm_P0.65mm

Connections:
+3.3V: R17.2; also elsewhere on the board
+5V: R14.1; also elsewhere on the board
/level_translator/485_1_A: U7.6 (A); also elsewhere on the board
/level_translator/485_1_B: U7.7 (B); also elsewhere on the board
/level_translator/485_2_A: U8.6 (A); also elsewhere on the board
/level_translator/485_2_B: U8.7 (B); also elsewhere on the board
/level_translator/RX0: JP3.1 (A), U9.4 (A3); also elsewhere on the board
/level_translator/RX1: JP4.1 (A), U9.5 (A4); also elsewhere on the board
/level_translator/TX0: JP1.1 (A), U9.2 (A1); also elsewhere on the board
/level_translator/TX1: JP2.1 (A), U9.3 (A2); also elsewhere on the board
/level_translator/UART_RX0: JP7.2 (C); also elsewhere on the board
/level_translator/UART_RX1: JP8.2 (C); also elsewhere on the board
/level_translator/UART_TX0: JP5.2 (C); also elsewhere on the board
/level_translator/UART_TX1: JP6.2 (C); also elsewhere on the board
GND: C30.2, C31.2, C32.2, C33.2, U7.5 (GND), U8.5 (GND), U9.7 (GND); also elsewhere on the board
unnamed: JP1.2 (B), JP5.3 (B), U9.13 (B1)
unnamed: JP2.2 (B), JP6.3 (B), U9.12 (B2)
unnamed: JP3.2 (B), JP7.3 (B), U9.11 (B3)
unnamed: JP4.2 (B), JP8.3 (B), U9.10 (B4)
unnamed: JP5.1 (A), U7.4 (DI)
unnamed: JP6.1 (A), U8.4 (DI)
unnamed: JP7.1 (A), U7.1 (RO)
unnamed: JP8.1 (A), U8.1 (RO)
unnamed: R15.2, U7.2 (~RE), U7.3 (DE)
unnamed: C30.1, C31.1, C33.1, R15.1, R16.1, R17.1, U7.8 (VCC), U8.8 (VCC), U9.14 (VCCB)
unnamed: R16.2, U8.2 (~RE), U8.3 (DE)
unnamed: C32.1, R14.2, U9.1 (VCCA), U9.8 (OE)

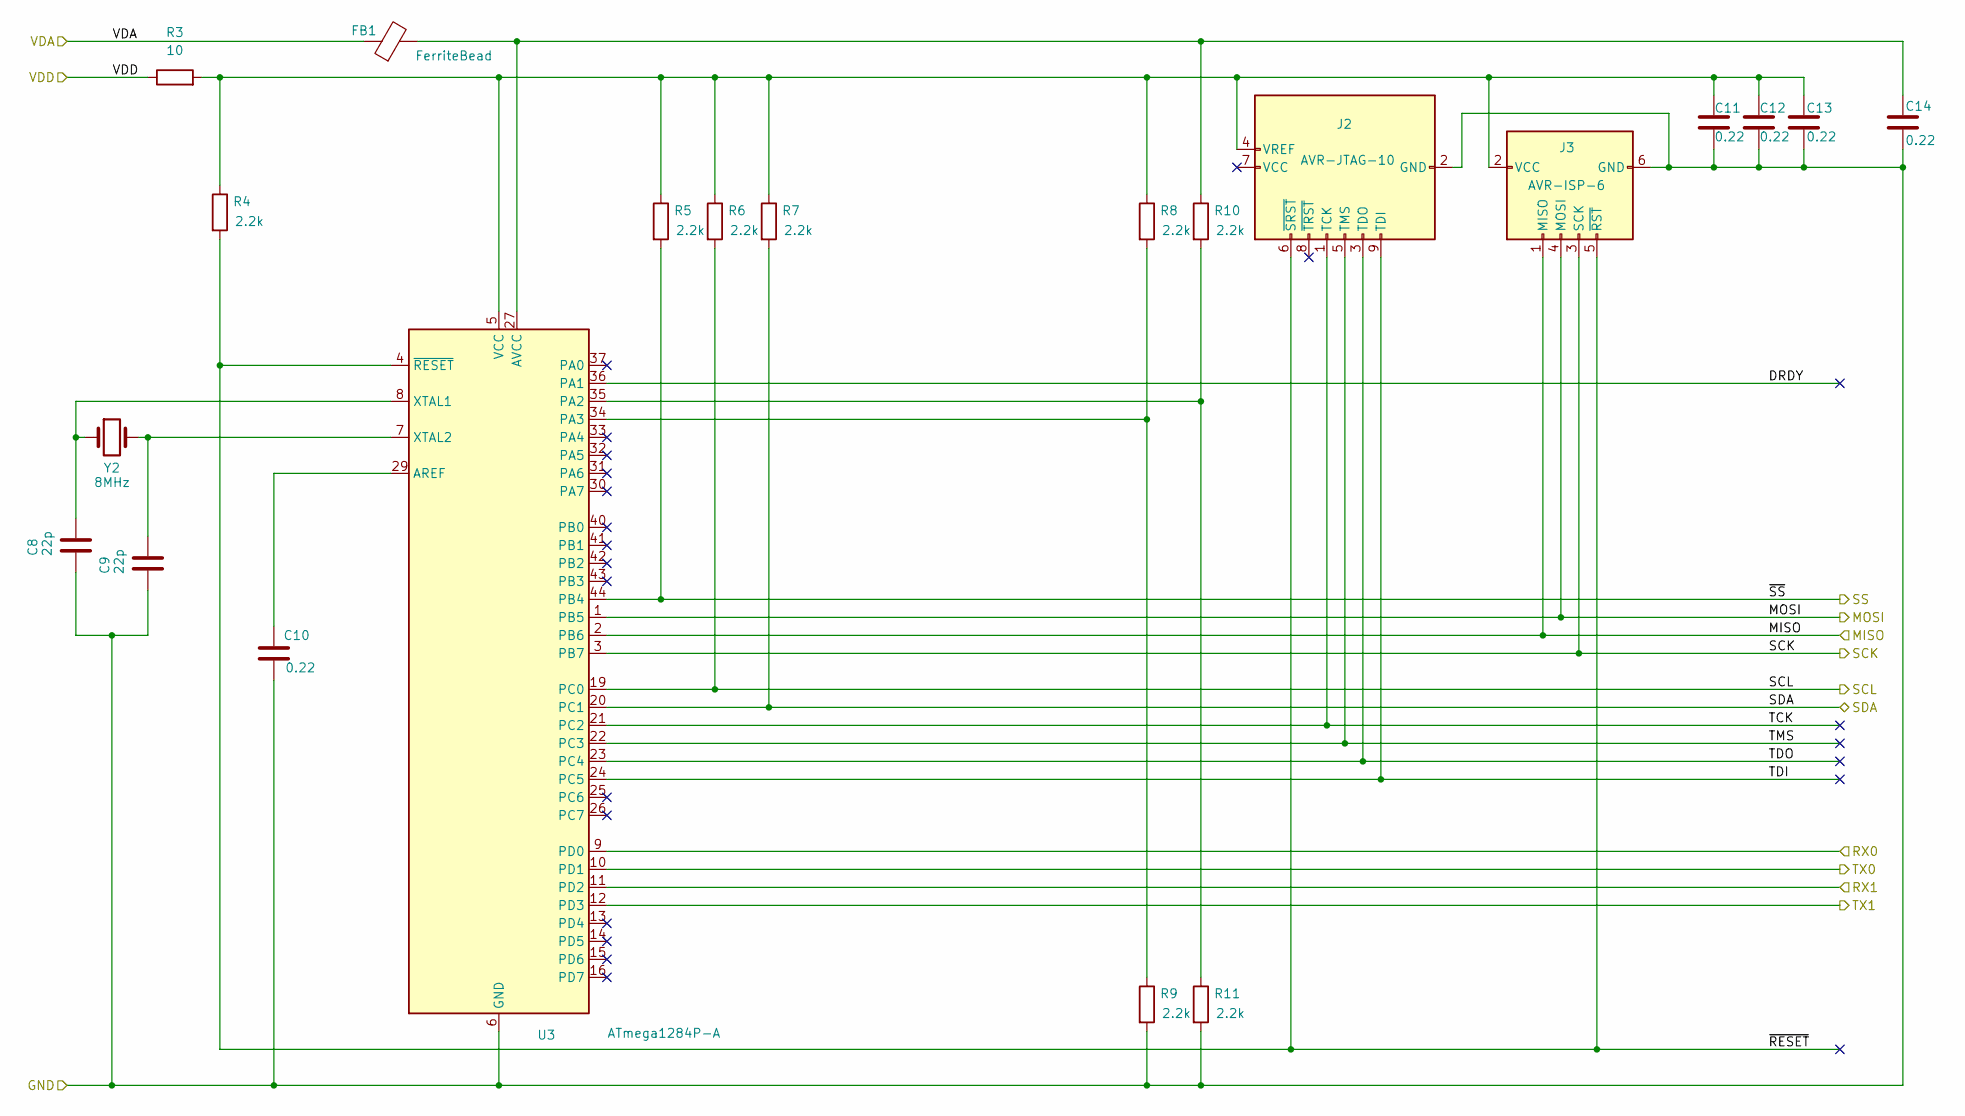
[picture p10: schematic mc.kicad_sch]

Parts:
C8, C9: 22p; C_0805_2012Metric
C10, C11, C12, C13, C14: 0.22; C_0805_2012Metric
FB1: FerriteBead; L_0805_2012Metric
J2: AVR-JTAG-10; PinHeader_2x05_P2.54mm_Vertical
J3: AVR-ISP-6; PinHeader_2x03_P2.54mm_Vertical
R3: 10; R_0805_2012Metric
R4, R5, R6, R7, R8, R9, R10, R11: 2.2k; R_0805_2012Metric
U3: ATmega1284P-A; TQFP-44_10x10mm_P0.8mm
Y2: 8MHz; Crystal_SMD_EuroQuartz_MQ2-2Pin_7.0x5.0mm

Connections:
+3.3V: R3.1; also elsewhere on the board
+3.3VA: FB1.1; also elsewhere on the board
/MISO: J3.1 (MISO), U3.2 (PB6); also elsewhere on the board
/MOSI: J3.4 (MOSI), U3.1 (PB5); also elsewhere on the board
/SCK: J3.3 (SCK), U3.3 (PB7); also elsewhere on the board
/SCL: R6.2, U3.19 (PC0); also elsewhere on the board
/SDA: R7.2, U3.20 (PC1); also elsewhere on the board
/SS: R5.2, U3.44 (PB4); also elsewhere on the board
/level_translator/UART_RX0: U3.9 (PD0); also elsewhere on the board
/level_translator/UART_RX1: U3.11 (PD2); also elsewhere on the board
/level_translator/UART_TX0: U3.10 (PD1); also elsewhere on the board
/level_translator/UART_TX1: U3.12 (PD3); also elsewhere on the board
/mc/DRDY: U3.36 (PA1)
/mc/TCK: J2.1 (TCK), U3.21 (PC2)
/mc/TDI: J2.9 (TDI), U3.24 (PC5)
/mc/TDO: J2.3 (TDO), U3.23 (PC4)
/mc/TMS: J2.5 (TMS), U3.22 (PC3)
/mc/~RESET: J2.6 (~SRST), J3.5 (~RST), R4.2, U3.4 (~RESET)
GND: C8.2, C9.2, C10.1, C11.1, C12.1, C13.1, C14.2, J2.2 (GND), J2.10 (GND), J3.6 (GND), R9.2, R11.2, U3.6 (GND), U3.18 (GND), U3.28 (GND), U3.39 (GND); also elsewhere on the board
unnamed: C11.2, C12.2, C13.2, J2.4 (VREF), J3.2 (VCC), R3.2, R4.1, R5.1, R6.1, R7.1, R8.1, U3.5 (VCC), U3.17 (VCC), U3.38 (VCC)
unnamed: C10.2, U3.29 (AREF)
unnamed: C14.1, FB1.2, R10.1, U3.27 (AVCC)
unnamed: R10.2, R11.1, U3.35 (PA2)
unnamed: R8.2, R9.1, U3.34 (PA3)
unnamed: C8.1, U3.8 (XTAL1), Y2.1
unnamed: C9.1, U3.7 (XTAL2), Y2.2

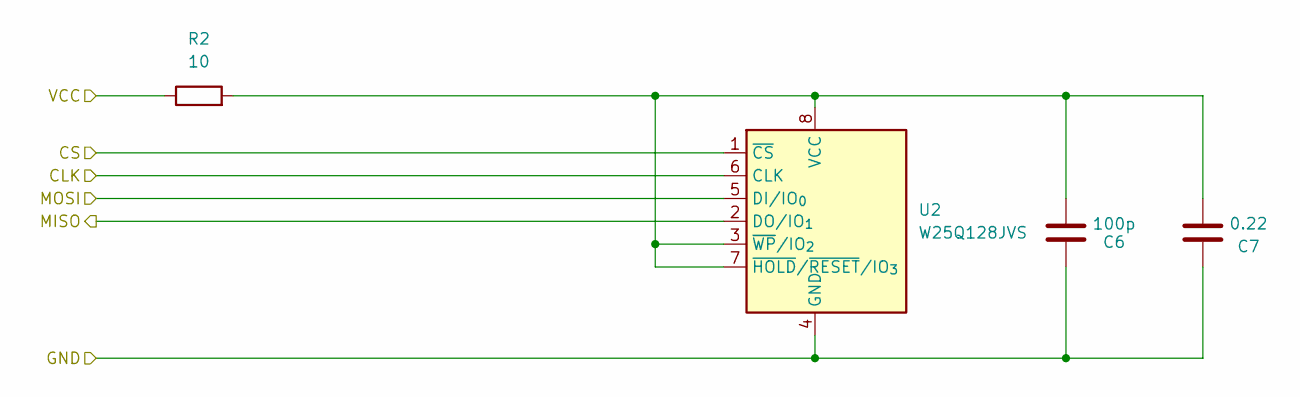
[picture p11: schematic sd-card.kicad_sch]

Parts:
C6: 100p; C_0805_2012Metric
C7: 0.22; C_0805_2012Metric
R2: 10; R_0805_2012Metric
U2: W25Q128JVS; SOIC-8_3.9x4.9mm_P1.27mm

Connections:
+3.3V: R2.1; also elsewhere on the board
/MISO: U2.2 (DO/IO_{1}); also elsewhere on the board
/MOSI: U2.5 (DI/IO_{0}); also elsewhere on the board
/SCK: U2.6 (CLK); also elsewhere on the board
/SS: U2.1 (~CS); also elsewhere on the board
GND: C6.1, C7.1, U2.4 (GND); also elsewhere on the board
unnamed: C6.2, C7.2, R2.2, U2.3 (~WP/IO_{2}), U2.7 (~HOLD/~RESET/IO_{3}), U2.8 (VCC)

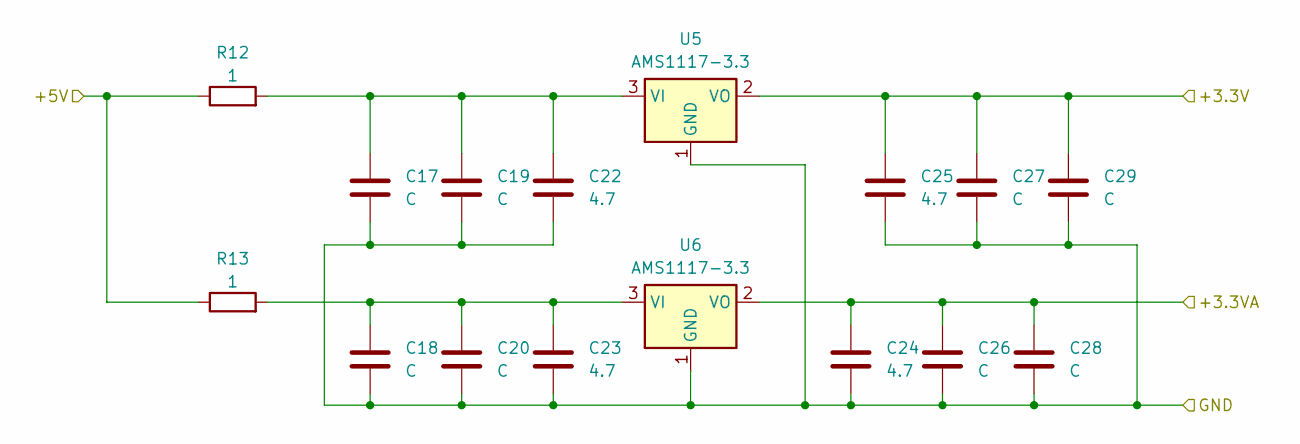
[picture p12: schematic power.kicad_sch]

Parts:
C17, C18, C19, C20, C26, C27, C28, C29: C; C_0805_2012Metric
C22, C23, C24, C25: 4.7; C_0805_2012Metric
R12, R13: 1; R_0805_2012Metric
U5, U6: AMS1117-3.3; SOT-223-3_TabPin2

Connections:
+3.3V: C25.1, C27.1, C29.1, U5.2 (VO); also elsewhere on the board
+3.3VA: C24.1, C26.1, C28.1, U6.2 (VO); also elsewhere on the board
+5V: R12.1, R13.1; also elsewhere on the board
GND: C17.2, C18.2, C19.2, C20.2, C22.2, C23.2, C24.2, C25.2, C26.2, C27.2, C28.2, C29.2, U5.1 (GND), U6.1 (GND); also elsewhere on the board
unnamed: C17.1, C19.1, C22.1, R12.2, U5.3 (VI)
unnamed: C18.1, C20.1, C23.1, R13.2, U6.3 (VI)

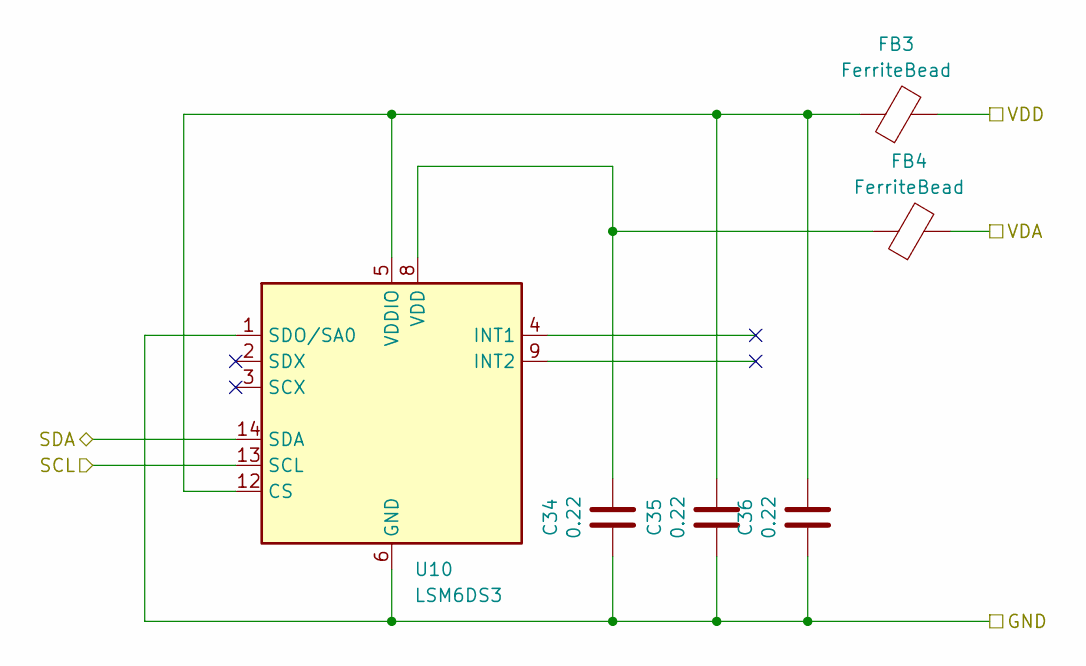
[picture p13: schematic imu.kicad_sch]

Parts:
C34, C35, C36: 0.22; C_0805_2012Metric
FB3, FB4: FerriteBead; L_0805_2012Metric
U10: LSM6DS3; LGA-14_3x2.5mm_P0.5mm_LayoutBorder3x4y

Connections:
+3.3V: FB3.2; also elsewhere on the board
+3.3VA: FB4.2; also elsewhere on the board
/SCL: U10.13 (SCL); also elsewhere on the board
/SDA: U10.14 (SDA); also elsewhere on the board
GND: C34.1, C35.1, C36.1, U10.1 (SDO/SA0), U10.6 (GND), U10.7 (GND); also elsewhere on the board
unnamed: C35.2, C36.2, FB3.1, U10.5 (VDDIO), U10.12 (CS)
unnamed: C34.2, FB4.1, U10.8 (VDD)

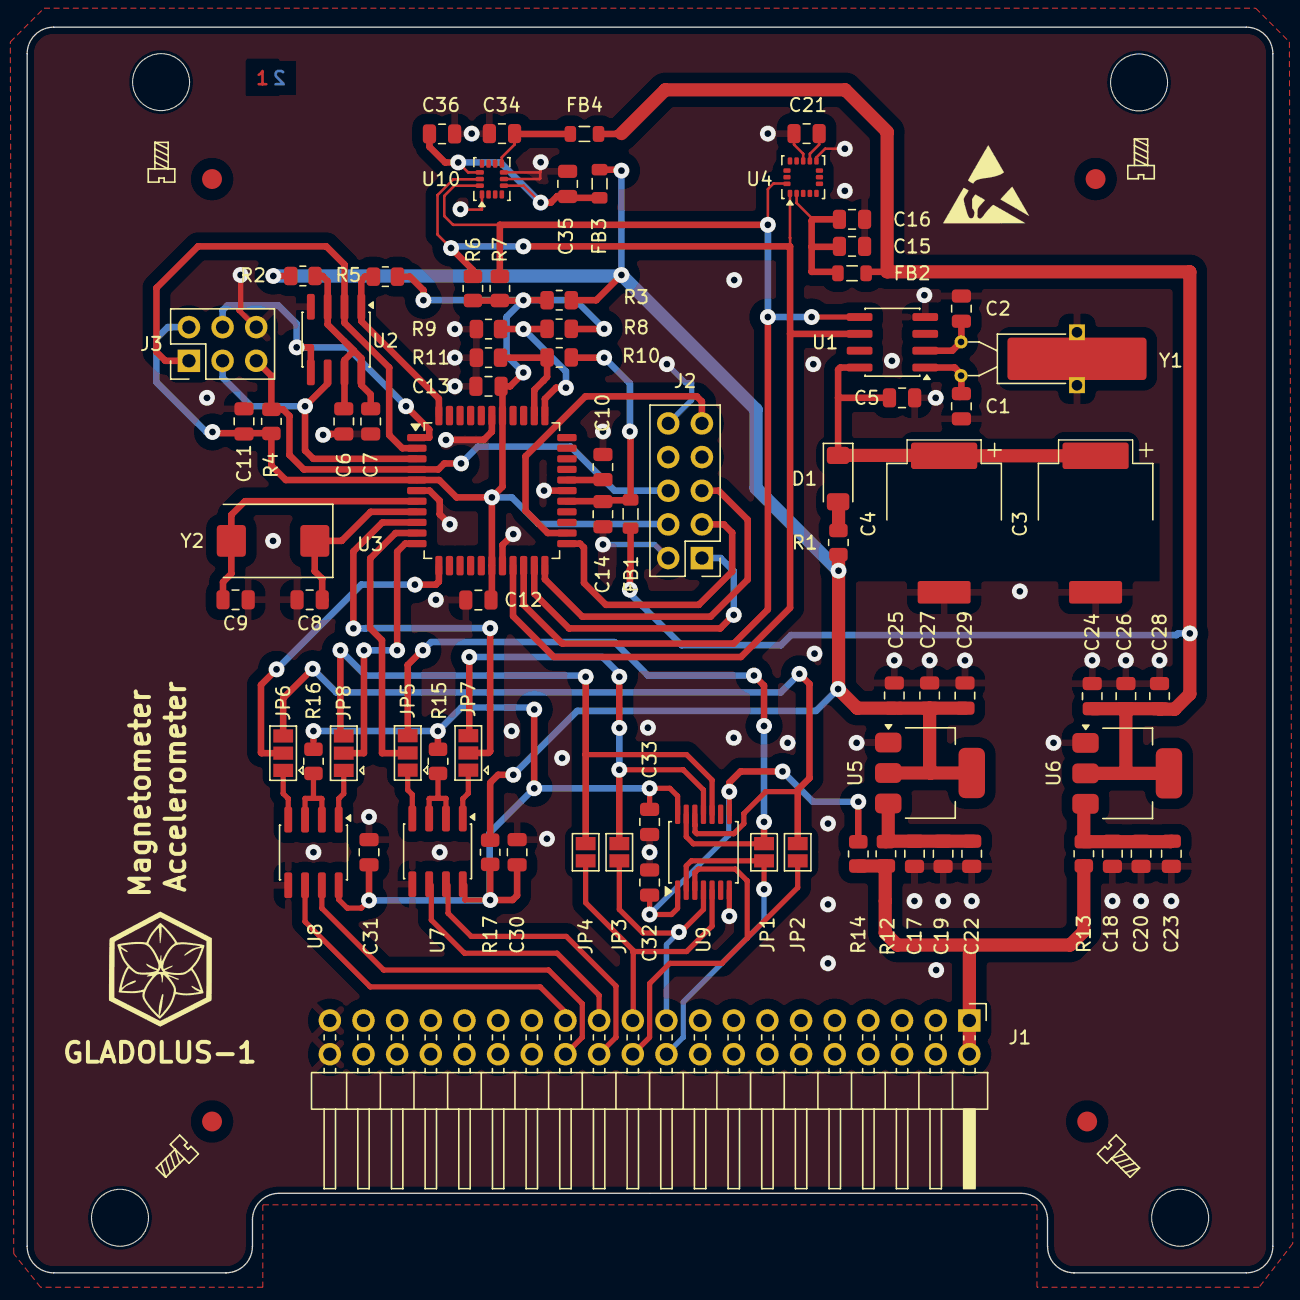
[picture p14: board 3axis-magnitometer.kicad_pcb from above]

Board: 2 copper layers, 94.0 x 94.0 mm, 82 parts (0 on the bottom side), 57 nets.

Other parts of the board:
GLADOLUS-1: LOGO; GLADIOLUS
