NarodniySputnik/Gladiolus-1/software/arduino_sstv_sx1276/main/main.ino

/*Это просто пример трансляции sstv с модуля SX1276 под управлением STM32F103C8 (bluepill)
STM общается с модулем SX1276 по SPI
Подключение модуля:
RST PB0
SCK PA5
MISO PA6
MOSI PA7
NSS PA4
DIO0 PA1
DIO2 PB10
режим AFSK. Проверить передачу можно при помощи sdr

Содержимое файла закинуть в Arduino IDE. Для того, чтобы прошить STM в Arduino IDE:
1. Скачайте свежую Arduino IDE 2.3 или новее (в старых версиях не работает, проверено).
2. Следуйте этой инструкции
https://community.st.com/t5/stm32-mcus/how-to-program-and-debug-the-stm32-using-the-arduino-ide/ta-p/608514
3. STM32 прошивается через ST-Link v2. Uoload method STM CubeProgrammer SWD

*/

#include <Arduino.h>
#include <RadioLib.h>

SX1278 radio = new Module(PA4, PA1, PB0, PB1);

AFSKClient audio(&radio, PB10);

// create SSTV client instance using the AFSK instance
SSTVClient sstv(&audio);

// test "image" - actually just a single 320px line
// will be sent over and over again, to create vertical color stripes at the receiver
uint32_t line[320] = {
  // black
  0x000000, 0x000000, 0x000000, 0x000000, 0x000000, 0x000000, 0x000000, 0x000000, 0x000000, 0x000000, 0x000000, 0x000000, 0x000000, 0x000000, 0x000000, 0x000000, 0x000000, 0x000000, 0x000000, 0x000000,
  0x000000, 0x000000, 0x000000, 0x000000, 0x00FF00, 0x000000, 0x000000, 0x000000, 0x000000, 0x000000, 0x000000, 0x000000, 0x000000, 0x000000, 0x000000, 0x000000, 0x000000, 0x000000, 0x000000, 0x000000,

  // blue
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
  // SSTV mode:                   Wrasse (SC2-180)
  state = sstv.begin(Robot72);
  if(state == RADIOLIB_ERR_NONE) {
    Serial.println(F("success!"));
  } else {
    Serial.print(F("failed, code "));
    Serial.println(state);
    while (true) { delay(10); }
  }

  // set correction factor
  // NOTE: Due to different speeds of various platforms
  //       supported by RadioLib (Arduino Uno, ESP32 etc),
  //       and because SSTV is analog protocol, incorrect
  //       timing of pulses can lead to distortions.
  //       To compensate, correction factor can be used
  //       to adjust the length of timing pulses
  //       (lower number = shorter pulses).
  //       The value is usually around 0.95 (95%).
  Serial.print(F("[SSTV] Setting correction ... "));
  state = sstv.setCorrection(0.88);
  if(state == RADIOLIB_ERR_NONE) {
    Serial.println(F("success!"));
  } else {
    Serial.print(F("failed, code "));
    Serial.println(state);
    while (true) { delay(10); }
  }

  // to help tune the receiver, SSTVClient can send
  // continuous 1900 Hz beep
  /*
    sstv.idle();
    while (true) { delay(10); }
  */
}

void loop() {
  // send picture with 8 color stripes
  Serial.print(F("[SSTV] Sending test picture ... "));

  // send synchronization header first
  sstv.sendHeader();

  // send all picture lines
  for(uint16_t i = 0; i < sstv.getPictureHeight(); i++) {
    sstv.sendLine(line);
  }

  // turn off transmitter
  radio.standby();

  Serial.println(F("done!"));

  delay(3000);
}
