NarodniySputnik/Gladiolus-1/(commit log)

2025-10-15 первое тз под правки
2025-10-15 Update README.md
    Изменение требований электропитания
2025-10-15 Update README.md
    конкретизированы требования к радиоканалу
2025-10-15 Update README.md
    дополнения тз функциональное и радиомодуль
2025-10-15 Update README.md
    частота сств
2025-10-15 Update README.md
    добавил конкретики и вопросов
2025-10-15 Update README.md
    конкретизация параметров
2025-10-15 фикс форматирования
2025-10-16 kicad init
    [gladiolus1.kicad_pcb, gladiolus1.kicad_sch]
2025-10-16 structure update
    [mainboard.kicad_pcb, mainboard.kicad_sch]
2025-10-16 structure improvements
    [receiver.kicad_pcb, receiver.kicad_sch, transmitter.kicad_pcb, transmitter.kicad_sch]
2025-10-16 добавлены шаблоны плат
    макетные платы от ранних проектов нужно переработать в шаблоны
    [template.kicad_pcb, template.kicad_sch]
2025-10-16 removed all unused holes
    [template.kicad_pcb]
2025-10-16 another one structure improvements
    [breadboard.kicad_pcb, breadboard.kicad_sch, mainboard.kicad_pcb, receiver.kicad_pcb, receiver.kicad_sch, template.kicad_pcb, template.kicad_sch, transmitter.kicad_pcb]
2025-10-16 add boards req
2025-10-17 продолжаем сохранять порядок
2025-10-17 renamed files
    [breadboard.kicad_pcb, breadboard.kicad_sch, template.kicad_pcb, template.kicad_sch]
2025-10-17 AB-IOT-433 footprint
2025-10-17 Update README.md
    актуализация изменений
2025-10-18 Update README.md
    убрал модуль управления. вме делает материнская плата
2025-10-18 Добавил плату магнитометра
    Добавил плату магнитометра
    [3axis-magnitometer.kicad_pcb, 3axis-magnitometer.kicad_sch, clock.kicad_sch, level_translator.kicad_sch, magnitometr.kicad_sch, mc.kicad_sch, power.kicad_sch, sd-card.kicad_sch]
2025-10-18 let's gooo
    [3axis-magnetometer.kicad_pcb, 3axis-magnetometer.kicad_sch, breadboard.kicad_pcb, breadboard.kicad_sch, clock.kicad_sch, level_translator.kicad_sch, magnetometr.kicad_sch, mc.kicad_sch]
2025-10-18 another renaming
    [main_bus_pinout.kicad_sch]
2025-10-20 raspberry pi zero symbol
2025-10-20 подпапки в DS
2025-10-20 1-wire микросхемы добавлены
2025-10-20 1-wire update ic list
2025-10-20 Update README.md выбрана микросхема супервизора питания
2025-10-20 Create MAX6301.pdf
    выбрана микросхема супервизора основного питания
2025-10-20 Update README.md
    супервизор питания
2025-10-20 removed unused pins on template schematic
    [motherboard.kicad_sch, receiver.kicad_sch, sstv.kicad_sch, template.kicad_sch, transmitter.kicad_sch]
2025-10-22 Create .gitkeep
    Create Antenna module components datasheet folder.
2025-10-22 Update iinfo developers, technical staff
    Uzzzio assign to antenna deployment mechanism
2025-10-23 продолжаем придерживаться структуры проекта
2025-10-31 изменена структура. добавлен новый модем
    [transmitter.kicad_pcb, transmitter.kicad_sch]
2025-11-01 выбран ключ с защитой от защелкивания
2025-11-03 add magnitomet
    [3axis-magnitometer.kicad_pcb, 3axis-magnitometer.kicad_sch, clock.kicad_sch, level_translator.kicad_sch, magnitometr.kicad_sch, mc.kicad_sch, power.kicad_sch, sd-card.kicad_sch]
2025-11-13 Update README.md
    Корректировка ТЗ
2025-11-13 вёрстка
2025-11-14 Create требование к интегрированной системе управления питанием
    Добавлено тз на систему управления питанием
2025-11-14 Update требование к интегрированной системе управления питанием
2025-11-22 дарю вёрстку
2025-11-22 правка вёрстки
2025-12-03 добавил орбитальные эмулятор
2025-12-07 Update требование к интегрированной системе управления питанием
    English translate
2026-01-06 Update README.md
    модемные блоки
2026-02-09 и создал бог проект, и назвал его stm-sstv
2026-02-19 Add read.me file for modem board
2026-02-19 Add files via upload
    Файлы платы RadioComm для KiCad ver 9.0
    [RadioComm.kicad_pcb, RadioComm.kicad_sch]
2026-02-26 начата новая трассировка
    [3axis-magnitometer.kicad_pcb, 3axis-magnitometer.kicad_sch, clock.kicad_sch, imu.kicad_sch, level_translator.kicad_sch, magnitometr.kicad_sch, mc.kicad_sch, power.kicad_sch]
2026-02-26 Добавлен документ системной блок-схемы
2026-02-27 апдейт блок-схемы
2026-03-02 трасировка магнитометра
    [3axis-magnitometer.kicad_pcb, imu.kicad_sch, level_translator.kicad_sch, sd-card.kicad_sch]
2026-03-02 исправил контур платы
    [3axis-magnitometer.kicad_pcb]
2026-03-02 апдейт блок-схемы модемного блока
2026-03-04 Магнитометр правки
    [3axis-magnitometer.kicad_pcb, clock.kicad_sch]
2026-03-05 Финальные правки трассировки
    [3axis-magnitometer.kicad_pcb, clock.kicad_sch, imu.kicad_sch, level_translator.kicad_sch, magnitometr.kicad_sch, mc.kicad_sch, power.kicad_sch, sd-card.kicad_sch]
2026-03-05 замена микросхемы преобразователя уровня
    [3axis-magnitometer.kicad_pcb, imu.kicad_sch, level_translator.kicad_sch]
2026-03-06 герберы и финальные правки
    [3axis-magnitometer-B_Cu.gbr, 3axis-magnitometer-B_Mask.gbr, 3axis-magnitometer-B_Paste.gbr, 3axis-magnitometer-B_Silkscreen.gbr, 3axis-magnitometer-Edge_Cuts.gbr, 3axis-magnitometer-F_Cu.gbr, 3axis-magnitometer-F_Mask.gbr, 3axis-magnitometer-F_Paste.gbr]
2026-03-06 исправления трассировки
    [3axis-magnitometer-B_Cu.gbr, 3axis-magnitometer-B_Mask.gbr, 3axis-magnitometer-B_Paste.gbr, 3axis-magnitometer-B_Silkscreen.gbr, 3axis-magnitometer-Edge_Cuts.gbr, 3axis-magnitometer-F_Cu.gbr, 3axis-magnitometer-F_Mask.gbr, 3axis-magnitometer-F_Paste.gbr]
2026-03-10 апдейт блок-схемы. Часть материнского блока
2026-04-07 релиз
    [3axis-magnitometer-B_Cu.gbr, 3axis-magnitometer-B_Mask.gbr, 3axis-magnitometer-B_Paste.gbr, 3axis-magnitometer-B_Silkscreen.gbr, 3axis-magnitometer-Edge_Cuts.gbr, 3axis-magnitometer-F_Cu.gbr, 3axis-magnitometer-F_Mask.gbr, 3axis-magnitometer-F_Paste.gbr]
